canpinaremre/kusbegi-teknofest/DOCUMENT/PAPERS/ecal2.JPG

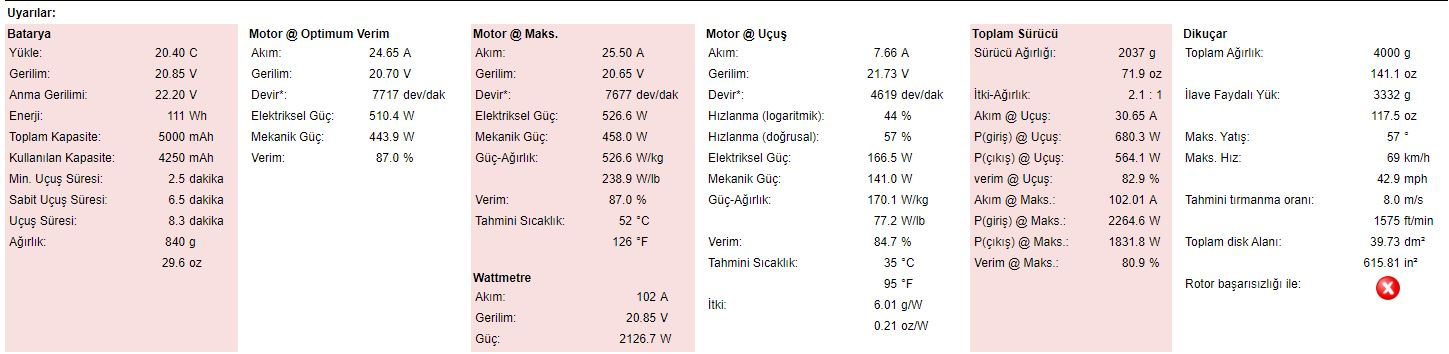
DOCUMENT/PAPERS/ecal2.JPG
