canpinaremre/kusbegi-teknofest/DOCUMENT/PAPERS/ecal1.JPG

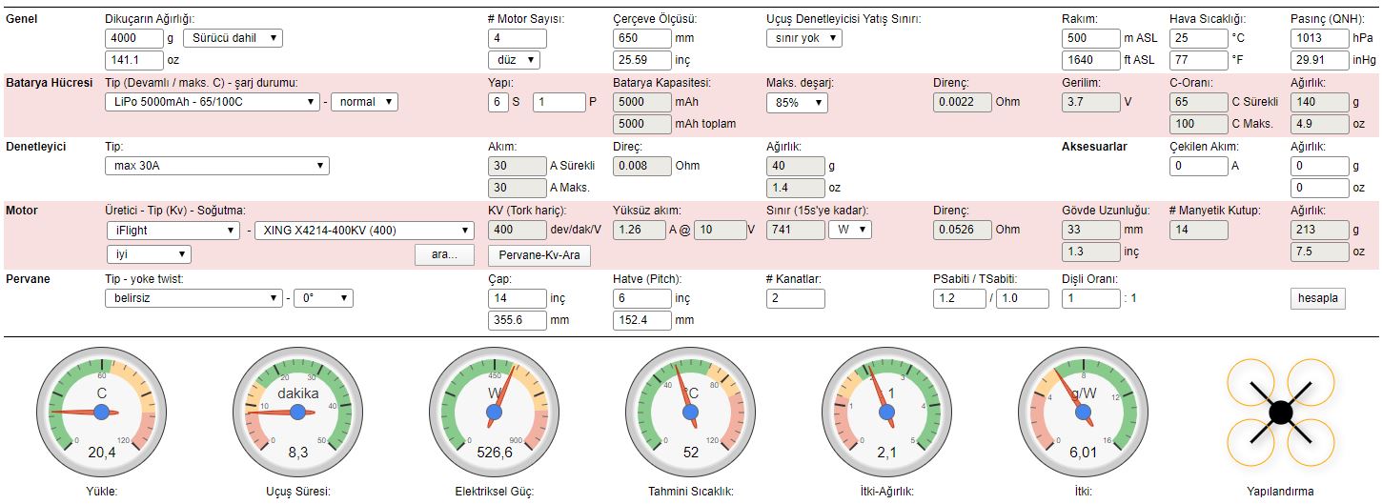
DOCUMENT/PAPERS/ecal1.JPG
