canpinaremre/kusbegi-teknofest/README.md

# kusbegi-teknofest

Araştırma kaynakları ve datasheetler RESEARCH klasörüne konulacak.

Oluşturulan belgeler ve datasetler DOCUMENT klasörüne konulacak.

Yazılımsal tüm içerikler CODE klasörüne konulacak.
