canpinaremre/kusbegi-teknofest/DOCUMENT/PAPERS/Motorlar.docx

SunnySky v3508

https://www.buddyrc.com/sunnysky-v3508-29-380kv.html

https://sunnyskyusa.com/products/sunnysky-v3508-motor

SunnySky v4014

https://sunnyskyusa.com/products/sunnysky-v4014-motors

SunnySky x3525

https://sunnyskyusa.com/products/sunnysky-x3525-brushless-motors-520kv-880kv

SunnySky 4108

https://www.roboshop.com.tr/x4108s-380kv-brushless-fircasiz-drone-motor
