canpinaremre/kusbegi-teknofest/DOCUMENT/PAPERS/COM(Center of Mass) Calculation of Drone.xlsx

Kullanılacak Parça | Ağırlığı(kg) | Ağırlık merkezi koordinatı(x ekseni(en)) | Ağırlık merkezi koordinatı(y ekseni(boy)) | Ağırlık merkezi koordinatı(z ekseni(yükseklik))
Jetson Nano | 0.145 | 67.910 | 0.000 | 73.500
Sigorta | 0.128 | -15.000 | 0.000 | 29.500
Pixhawk 4 | 0.060 | -10.270 | 0.000 | 65.000
GPS + GPS holder | 0.075 | -72.610 | 0.000 | 134.000
Pixhawk Power Module(PM07) | 0.040 | 107.000 | 0.000 | 29.500
Xbee | 0.040 | -30.710 | 91.880 | 64.000
Gövde | 0.393 | 0.000 | 5.000 | 29.500
Motor Tutucu Borular | 0.092 | 0.000 | 0.000 | -11.000
Motorlar(4 adet) | 0.452 | 0.000 | 0.000 | -1.750
Pervaneler(2 adet) | 0.075 | 0.000 | 0.000 | 30.500
Motor Tutucu(4 adet) | 0.088 | 0.000 | 0.000 | -9.500
Vida(67 adet) | 0.134 | 0.000 | 0.000 | -167.000
ESC'ler(4 adet) | 0.092 | 0.000 | 0.000 | 3.000
Pil(6S lipo) | 0.680 | 0.000 | -18.500 | 25.500
Kol sabitleyici(Merkez) | 0.045 | 0.000 | 0.000 | -1.500
Kol sabitleyici(Köşeler - 4 Adet) | 0.060 | 0.000 | 0.000 | -10.000
Receiver | 0.016 | -41.530 | -67.890 | 66.000
UBEC | 0.011 | 0.000 | 102.000 | 29.500
Kablolar | 0.100 | -55.000 | -8.000 | 59.000
Su sensörü ve Motor Sürücü | 0.031 | -74.480 | -84.550 | 63.000
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
