canpinaremre/kusbegi-teknofest/DOCUMENT/PAPERS/Drone Malzemelerinin Boyut ve Ağırlıkları.xlsx

İsim | Boy(cm) | En(cm) | Yükseklik (cm) | Ağırlık(gr)
Pi camera v2 | 25 | 23.86 |  | 3
Jetson Nano | 10 | 8 | 2.9 | 250
Pil (6s) (Profuse 22,2V 7000 mAh) | 15 | 7 | 4.3 | 906
Motor (SunnySky V5210) |  |  |  | 1200
ESC(Sunnysky BLHeli R45A) | 3.9 | 1.8 | 0.4 | 19.3
Pixhawk 4 | 4.4 | 8.4 | 1.2 | 15.8
GPS (Çap = 5 cm) |  |  |  | 36
Pixhawk Power Module | 17 | 5 | 3 | 0.105
Su Pompası (QR30E) | 5.4 | 3.7 | 4.2 | 64
Su(1 lt) |  |  |  | 1000
Sigorta | ? | ? | ? | ?
BEC (Matek PDB-XT60) | 3.6 | 5 | 0.4 | 11
