canpinaremre/kusbegi-teknofest/DOCUMENT/PAPERS/Drone Motor.xlsx

Motor Adı | Max. Akım(A) | KV Değeri | Ağırlık(g) | Max. Thrust(g) | Verim | Prop(inch) | Fiyat(TL) | Volt (V) | Link:
Emax ECO Series 2207 | 32.2 | 1900 | 31 | 1880 | ? | 5 | 264,44 (4PCS) | ? | https://www.banggood.com/4PCS-Emax-ECO-Series-2306-6S-1700KV-Brushless-Motor-for-RC-Drone-FPV-Racing-p-1582958.html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
Racerstar AirA 2508 | 34.7 | 1200 | 46 | 2026 | 2.53 | 7 | 121.77 | 18 | https://www.banggood.com/Racerstar-AirA-2508-1200KV-4-6S-Brushless-Motor-for-Long-Range-X-Class-RC-Drone-FPV-Racing-MultiRotors-p-1454072.html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
Airbot VITE 2306.5 | 34.5 | 1800 | 33.55 | 2772 | 2.115 | 6 | 116.78 | 21 | https://www.banggood.com/Airbot-VITE-2306_5-1800KV-5-6S-2500KV-3-5S-Brushless-Motor-CW-Thread-for-RC-Drone-FPV-Racing-p-1593369.html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
SunnySky X4110S | 18.8 | 400 | 165 | 2430 | 5.82 | 15 | 516.51 | 22.2 | https://www.dronmarket.com/urun/sunnysky-x4110s-drone-motoru
 | 26.6 | 400 | 165 | 2930 | 4.96 | 16 | 516.51 | 22.2
 | 27.7 | 400 | 165 | 3130 | 5.09 | 17 | 516.51 | 22.2
 | 32.2 | 400 | 165 | 3300 | 5.2 | 18 | 516.51 | 22.2
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
