canpinaremre/kusbegi-teknofest/DOCUMENT/PAPERS/DRONE.xlsx

VOLTAGE | PROPELLER | Current | Thrust(g) | Speed(rpm)
24 | DJI 1550 | 9 | 1470 | 5530
24 | DJI 1550 | 10 | 1570 | 5760
24 | DJI 1550 | 11 | 1710 | 5900
24 | DJI 1550 | 12 | 1760 | 6130
24 | DJI 1550 | 13 | 1880 | 6240
24 | DJI 1550 | 14.3 | 2020 | 6450
24 | DJI1655 | 9 | 1530 | 5040
24 | DJI1655 | 10 | 1640 | 5230
24 | DJI1655 | 11 | 1750 | 5390
24 | DJI1655 | 12 | 1830 | 5520
24 | DJI1655 | 13 | 1950 | 5670
24 | DJI1655 | 14 | 2050 | 5790
24 | DJI1555 | 9 | 1500 | 5190
24 | DJI1555 | 10 | 1620 | 5400
24 | DJI1555 | 11 | 1730 | 5530
24 | DJI1555 | 12 | 1820 | 5720
24 | DJI1555 | 13 | 1910 | 5890
24 | DJI1555 | 14 | 2020 | 6000
VOLTAGE | PROPELLER | CURRENT | THRUST | KV
24 | 1660 | 6 | 1311 | 400
24 | 1660 | 10 | 1959 | 400
24 | 1660 | 14.5 | 2564 | 400
24 | 1660 | 20.6 | 3260 | 400
24 | 1560 | 8.6 | 1659 | 400
24 | 1560 | 10.2 | 1904 | 400
24 | 1560 | 17.1 | 2765 | 400
24 | 1560 | 22.3 | 3330 | 400
24 | 1460 | 6.3 | 1267 | 400
24 | 1460 | 9.3 | 1705 | 400
24 | 1460 | 12.9 | 2146 | 400
24 | 1460 | 17.4 | 2683 | 400
VOLTAGE | PROPELLER | AMPS | Thrust | KV
22.2 | 1250 | 9.8 | 1400 | 350
25 | 1250 | 8.5 | 1395 | 350
25 | 1238 | 9.3 | 1400 | 350
25 | 1238 | 10.9 | 1600 | 350
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
