canpinaremre/kusbegi-teknofest/DOCUMENT/PAPERS/İş zaman çizelgesi.xlsx

GÖREVLER | 2020-02-24 | 2020-03-02 | 2020-03-09 | 2020-03-16 | 2020-03-23 | 2020-03-30 | 2020-04-06 | 2020-04-13 | 2020-04-20 | 2020-04-27 | 2020-05-04 | 2020-05-11 | 2020-05-18 | 2020-05-25 | 2020-06-01 | 2020-06-08 | 2020-06-15 | 2020-06-22 | 2020-06-29 | 2020-07-06 | 2020-07-13 | 2020-07-20 | 2020-07-27 | 2020-08-03 | 2020-08-10 | 2020-08-17 | 2020-08-24
Takım içi görevlendirilmelerinin verilmesi ve organizasyonun oluşturulması | X
Genel tasarımın belirlenmesi |  | X
Konfigürasyonun belirlenmesi ve güç parçalarının seçilmesi |  |  | X
İlk tasarımın oluşturulması |  |  | X
Üretim araçlarının araştırılması |  |  |  | X
İlk prototipin oluşturulması ve üretimi
Hataların belirlenmesi ve hataları düzelterek modelin geliştirilmesi
Kullanılacak yazılımın simülasyonu |  |  |  | X
İlk uçuş testlerinin yapılması
Otonom uçuş testlerinin gerçekleştirilmesi
Yarışma düzenin kurulması ve yarışma testlerinin gerçekleştirilmesi
Gerekli yazılımsal ayarlamaların tamamlanması ve son ürüne ulaşma
