canpinaremre/kusbegi-teknofest/DOCUMENT/SOLIDWORKS/DRONE V1 GÖRÜNTÜ 1.PNG

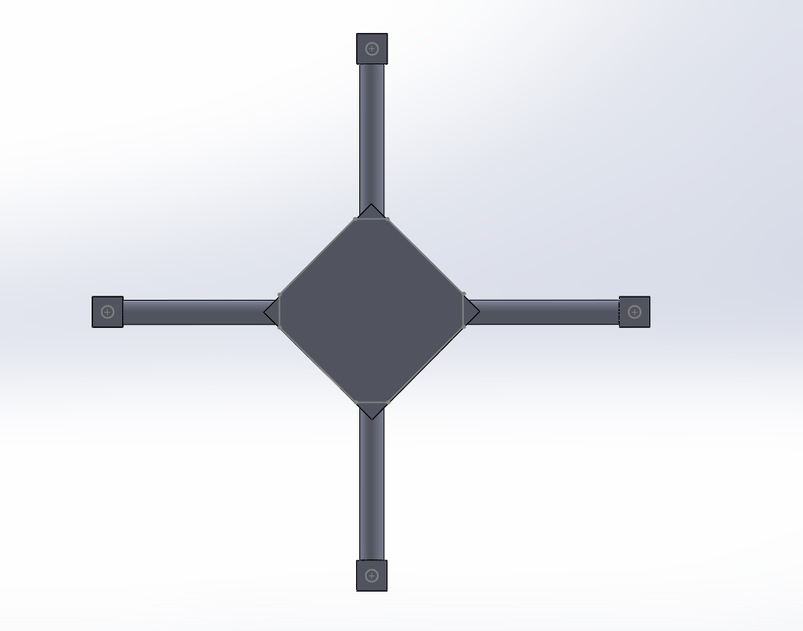
DOCUMENT/SOLIDWORKS/DRONE V1 GÖRÜNTÜ 1.PNG
