canpinaremre/kusbegi-teknofest/DOCUMENT/SOLIDWORKS/DRONE V1 GÖRÜNTÜ 2.PNG

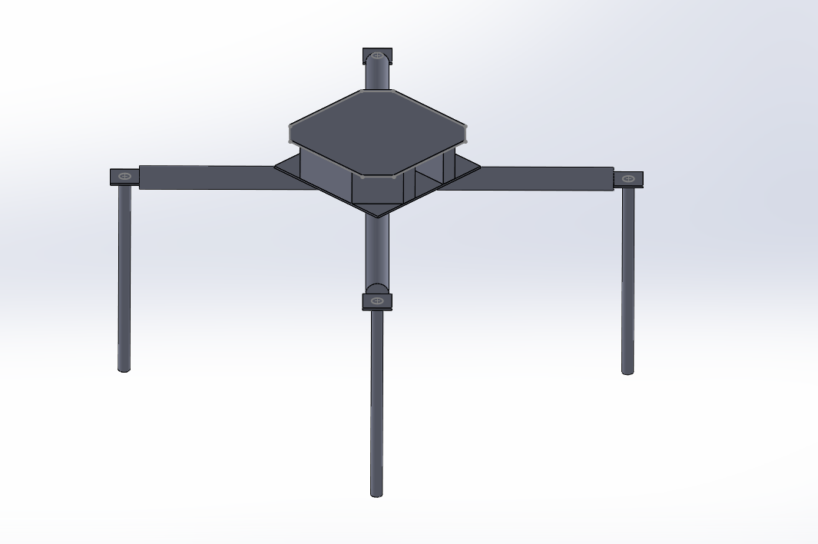
DOCUMENT/SOLIDWORKS/DRONE V1 GÖRÜNTÜ 2.PNG
