canpinaremre/kusbegi-teknofest/DOCUMENT/SOLIDWORKS/DRONE V1 GÖRÜNTÜ 3.PNG

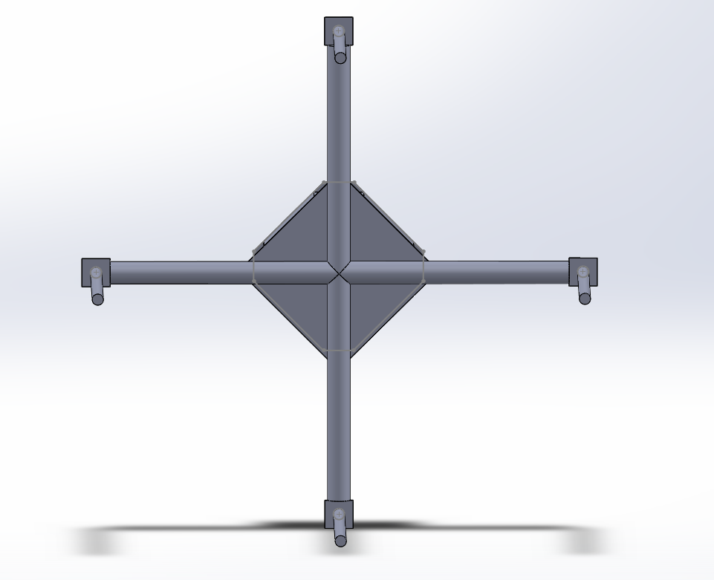
DOCUMENT/SOLIDWORKS/DRONE V1 GÖRÜNTÜ 3.PNG
