canpinaremre/kusbegi-teknofest/DOCUMENT/SOLIDWORKS/DRONE V1 GÖRÜNTÜ 4.PNG

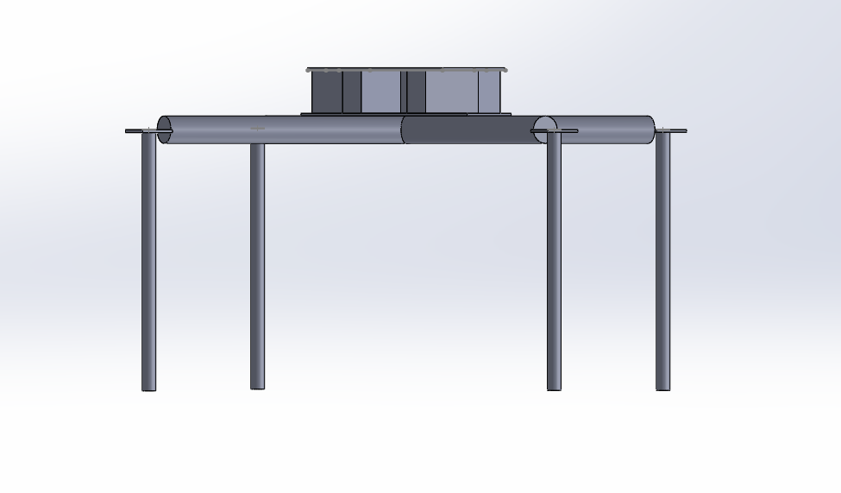
DOCUMENT/SOLIDWORKS/DRONE V1 GÖRÜNTÜ 4.PNG
