canpinaremre/kusbegi-teknofest/DOCUMENT/SOLIDWORKS/DRONE V1 GÖRÜNTÜ 5.PNG

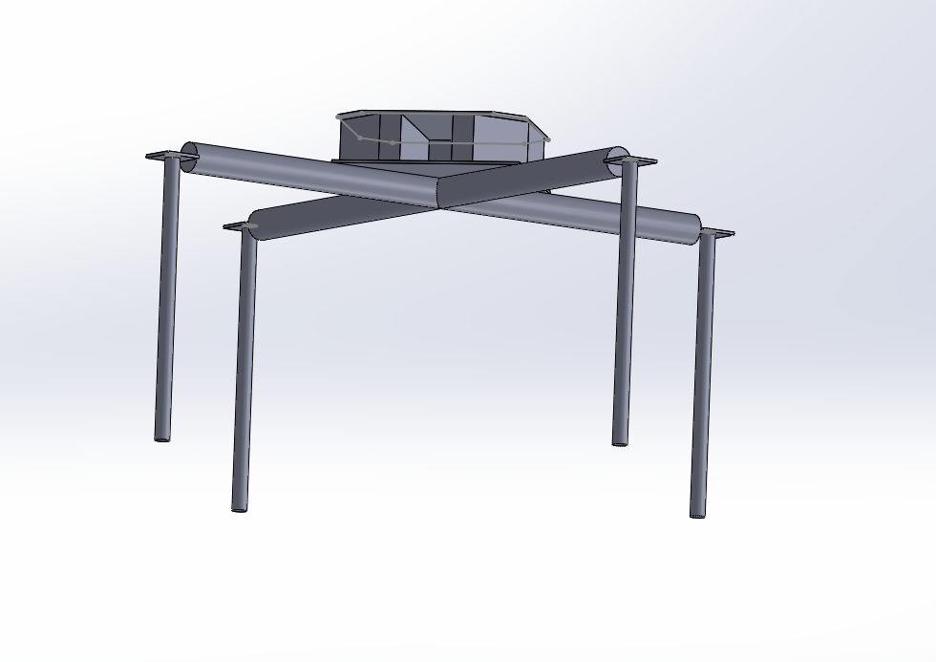
DOCUMENT/SOLIDWORKS/DRONE V1 GÖRÜNTÜ 5.PNG
