canpinaremre/kusbegi-teknofest/DOCUMENT/SOLIDWORKS/DRONE V1 GÖRÜNTÜ 6.PNG

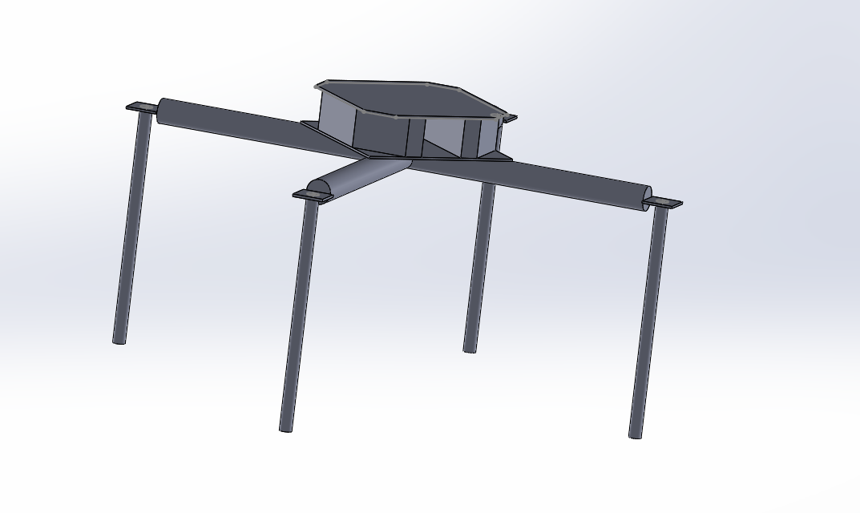
DOCUMENT/SOLIDWORKS/DRONE V1 GÖRÜNTÜ 6.PNG
