canpinaremre/kusbegi-teknofest/DOCUMENT/SOLIDWORKS/DRONE V1 GÖRÜNTÜ 7.PNG

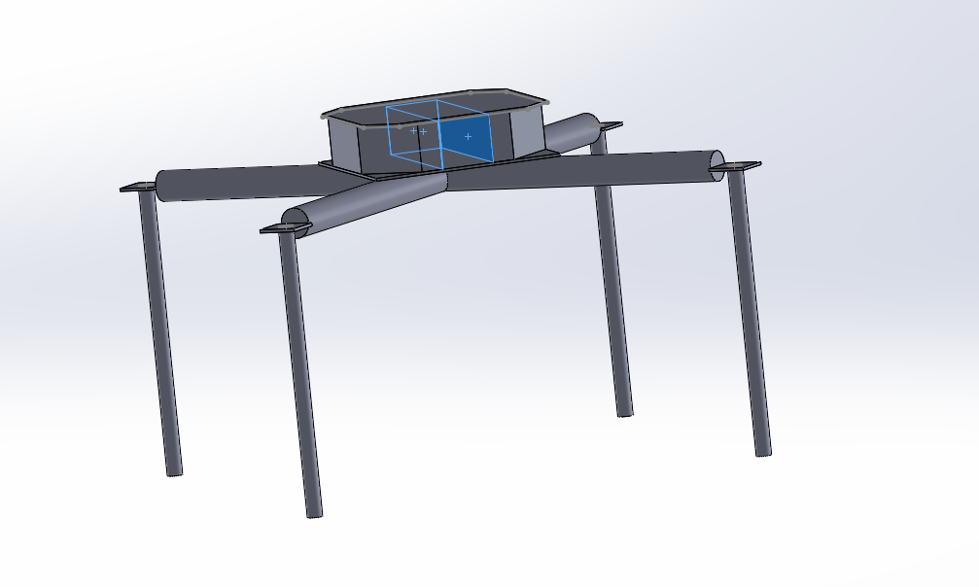
DOCUMENT/SOLIDWORKS/DRONE V1 GÖRÜNTÜ 7.PNG
