canpinaremre/kusbegi-teknofest/DOCUMENT/SOLIDWORKS/DRONE V1 GÖRÜNTÜ 8.PNG

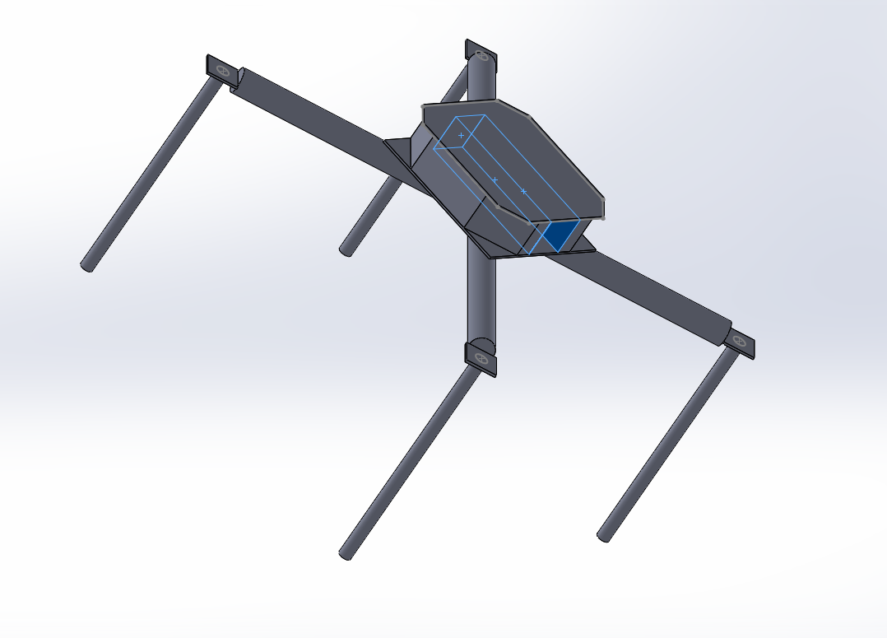
DOCUMENT/SOLIDWORKS/DRONE V1 GÖRÜNTÜ 8.PNG
