canpinaremre/kusbegi-teknofest/(list of files, cad)

Other CAD files:
DOCUMENT/SOLIDWORKS/kusbegi.dwg
