canpinaremre/kusbegi-teknofest/CODE/circuit diagram v4.pdf

# Li-po Batarya 6s

# Sigorta

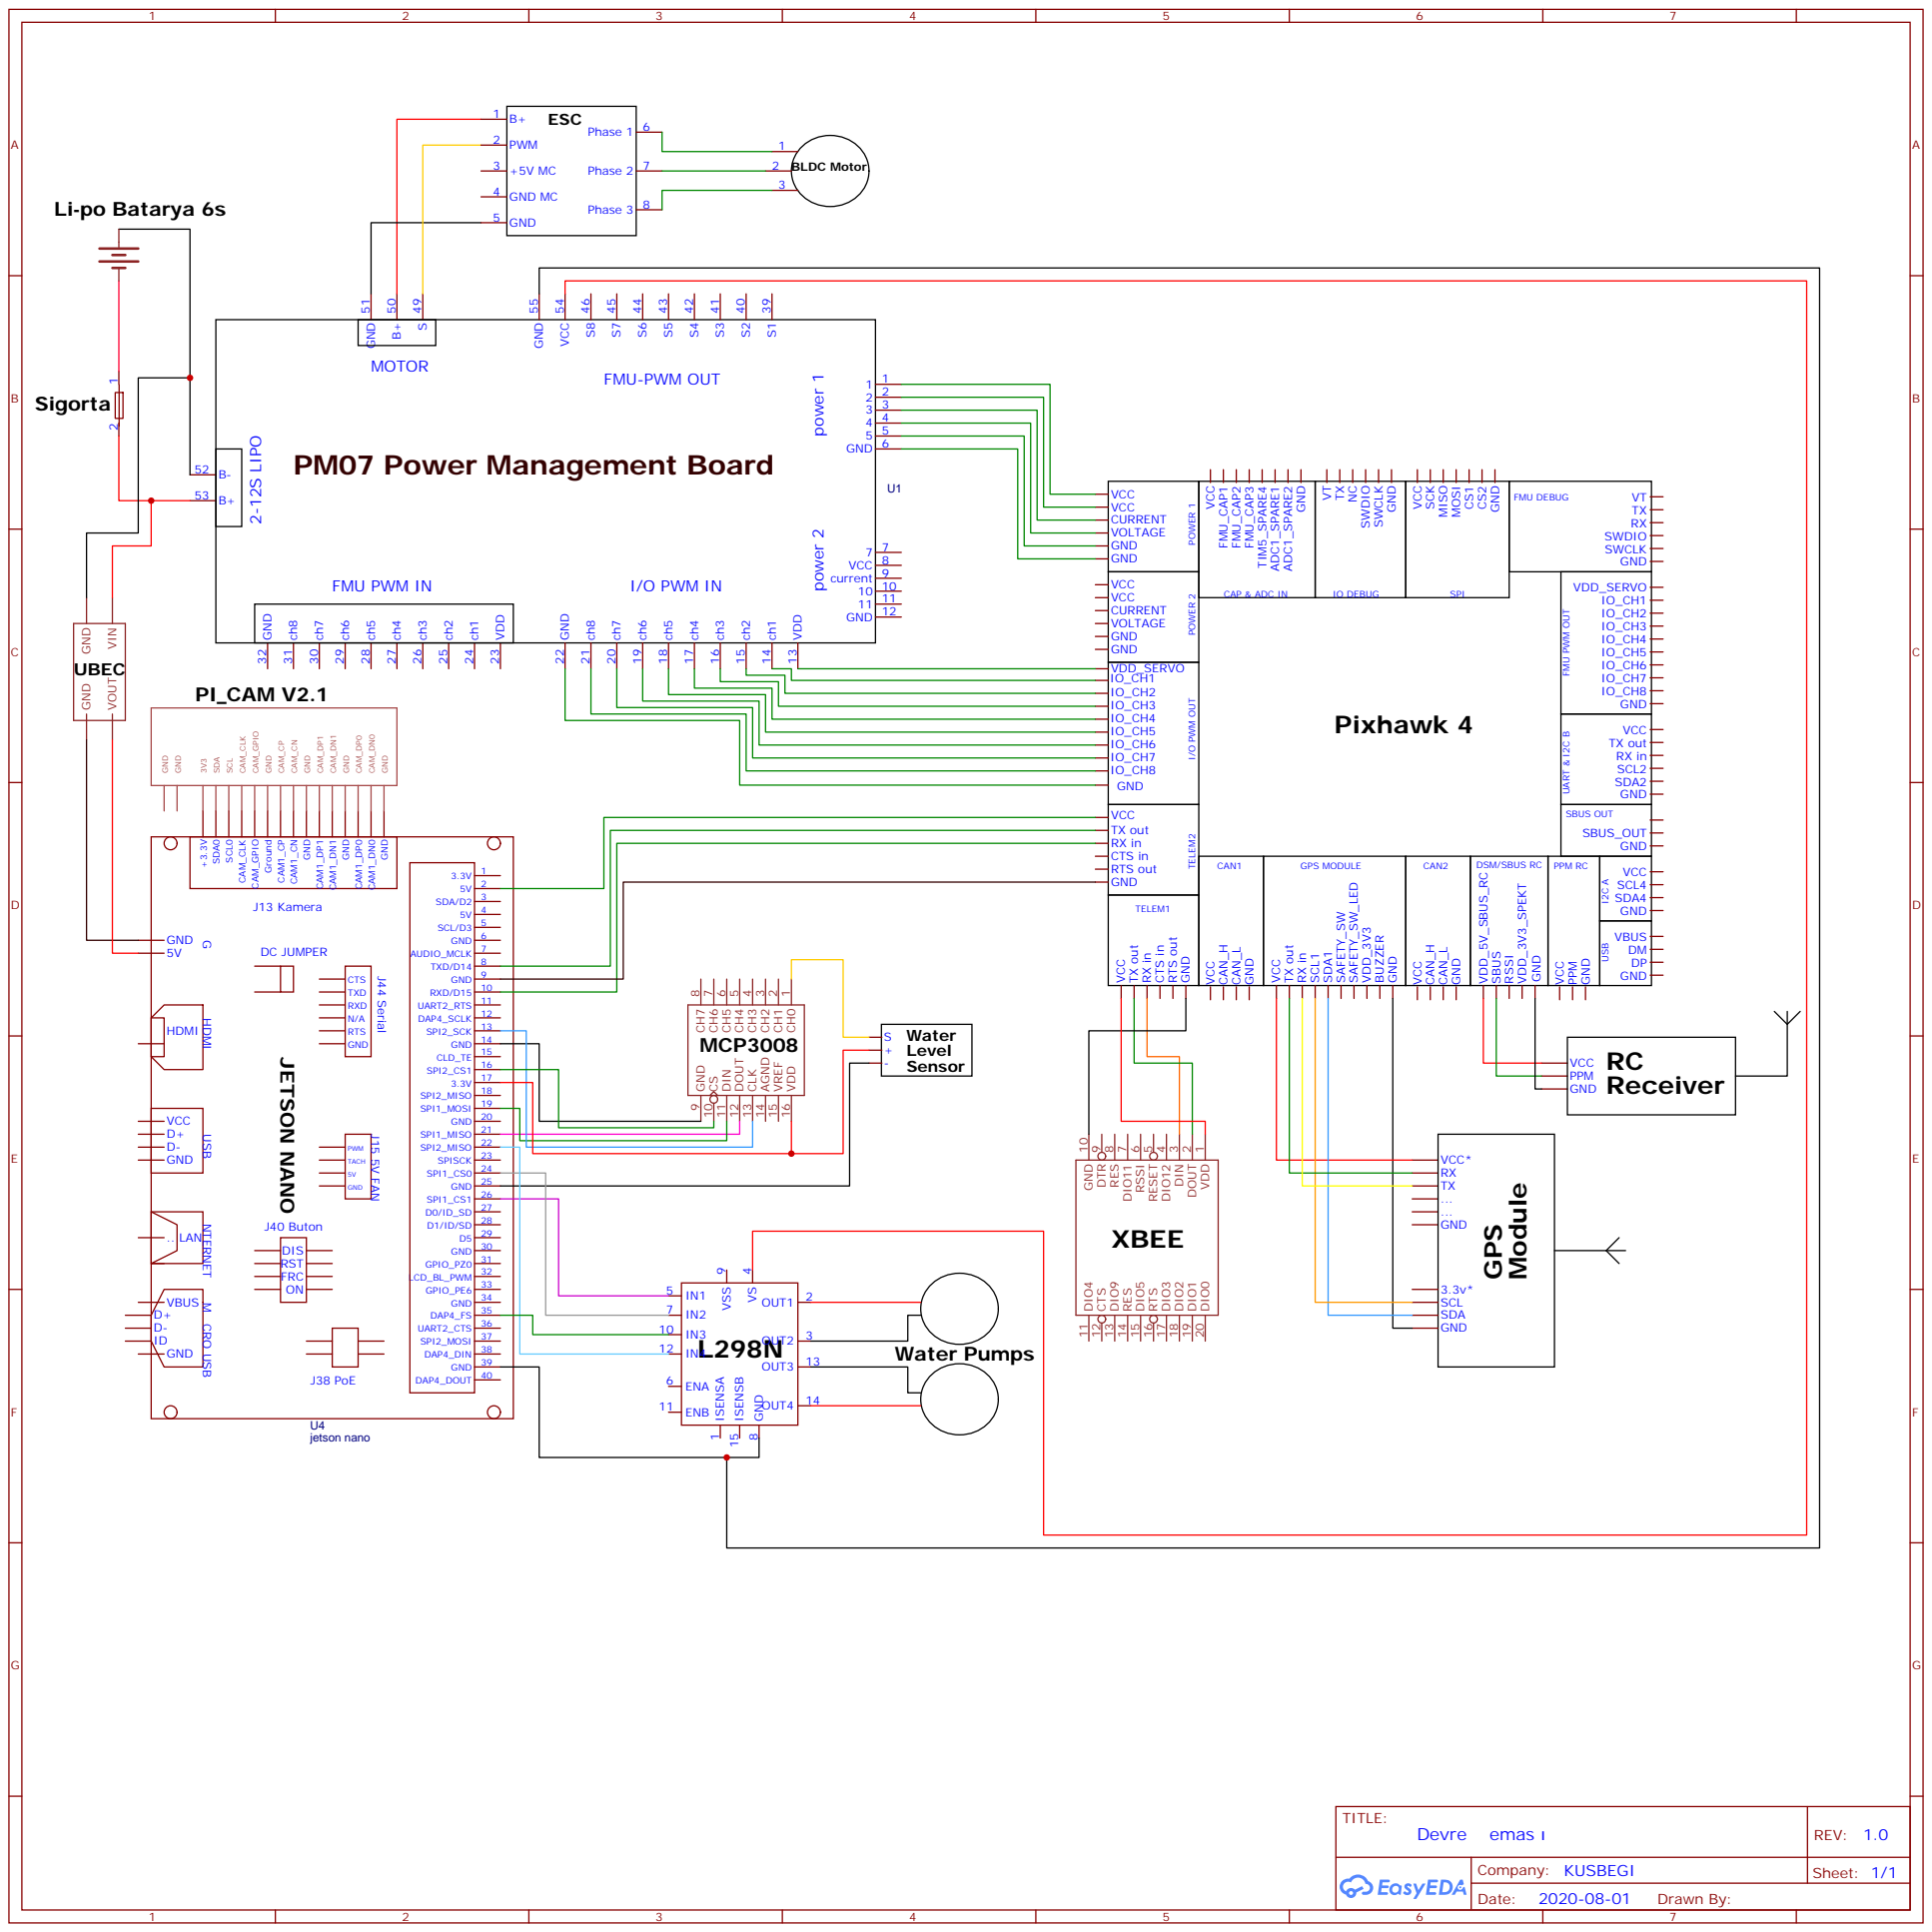
[picture p34: page 1]

SBUS OUT
SBUS_OUT
GND
PPM RC VCC PPM GND

MCP3008 CS 10 DIN 11 DOUT 12 CLK 13 AGND 14 VREF 15 VDD 16 GND
