canpinaremre/kusbegi-teknofest/RESEARCH/Schematic_circuitdiag_2020-07-17_20-28-37.pdf

A

A

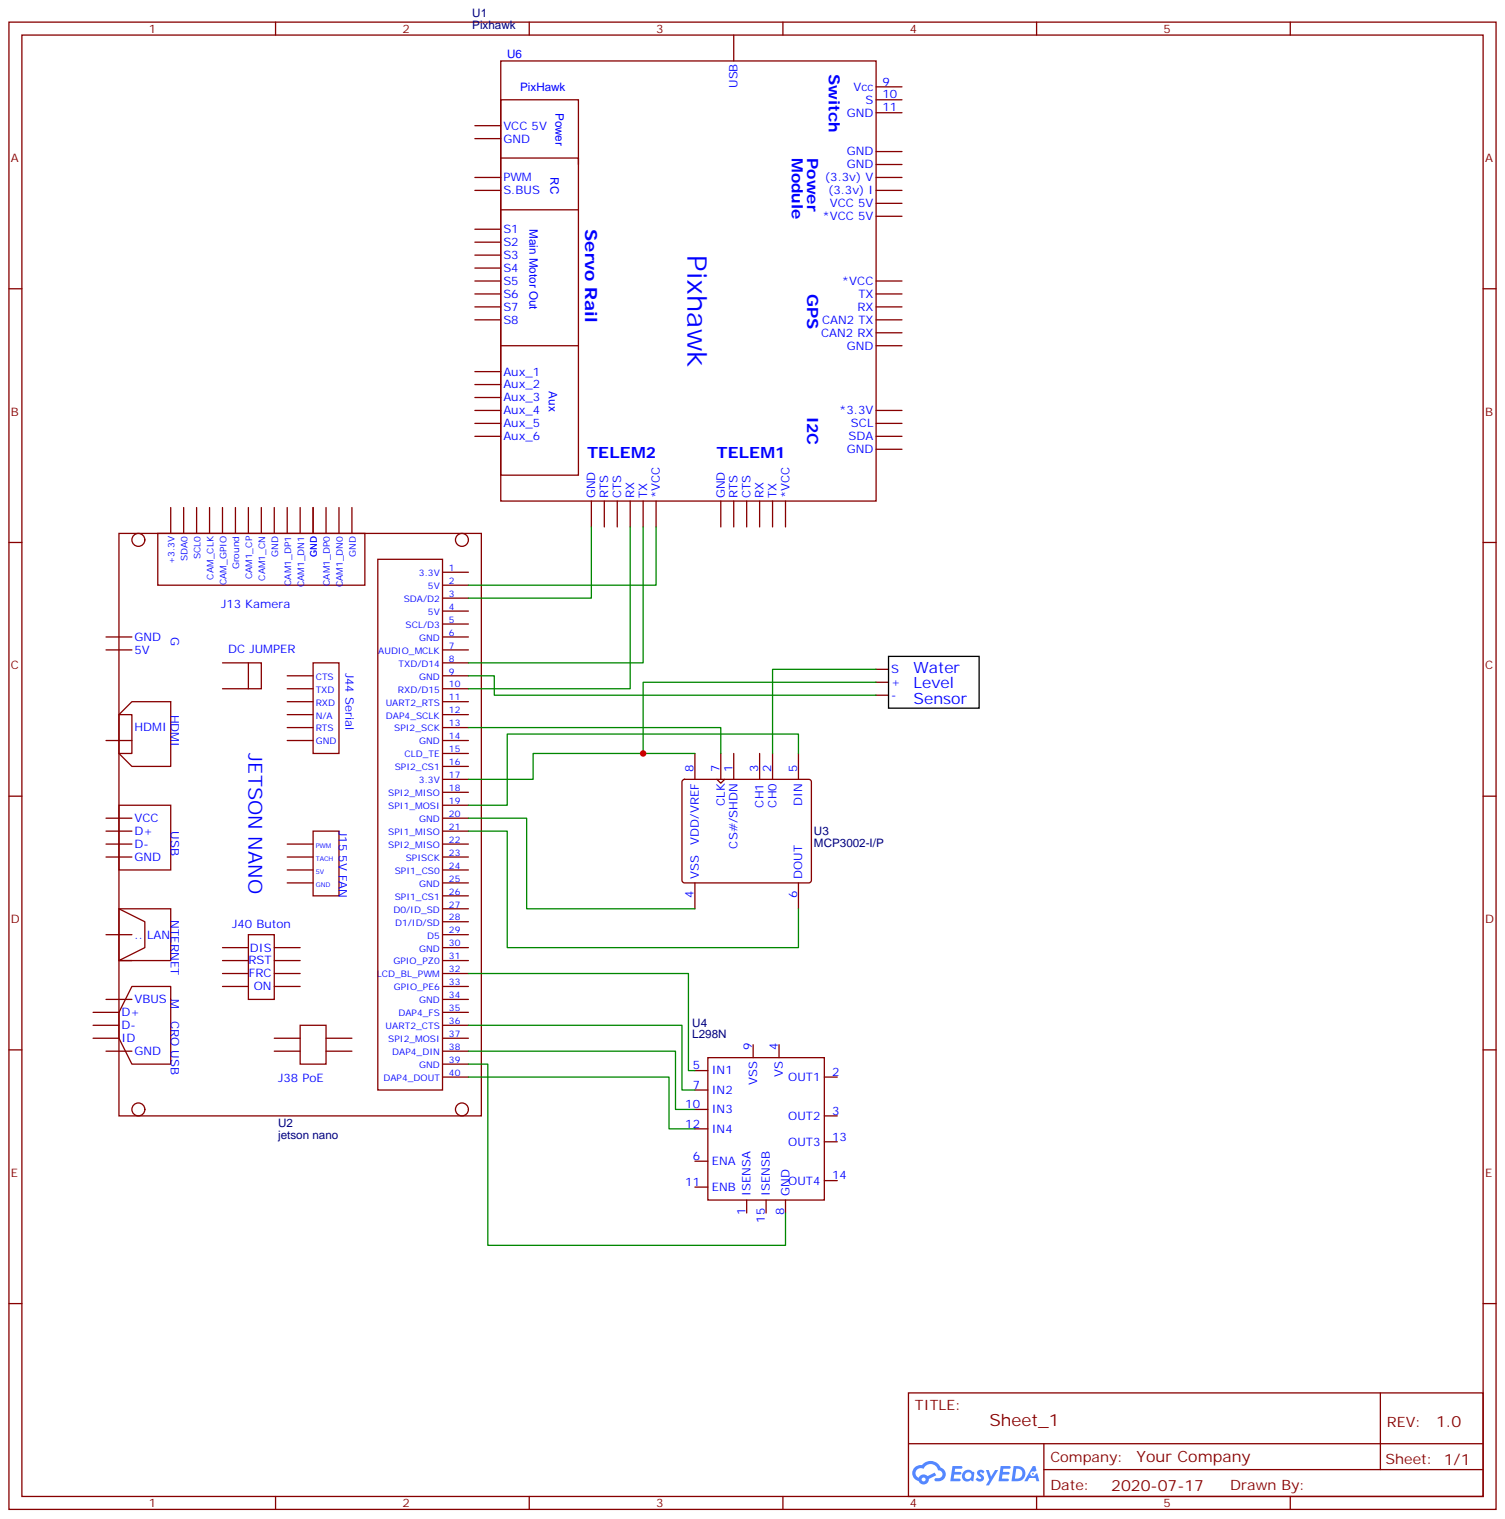
[picture p35: page 1]

G HDMI USB NTERNET M CRO USB
