canpinaremre/kusbegi-teknofest/CODE/water_sensor_v4.py

import RPi.GPIO as GPIO
import time

# change these as desired - they're the pins connected from the
# SPI port on the ADC to the Cobbler
SPICLK = 13
SPIMISO = 21
SPIMOSI = 19
SPICS = 16

# photoresistor connected to adc #0
photo_ch = 0


# port init
def init():
    GPIO.setwarnings(False)
    GPIO.cleanup()  # clean up at the end of your script
    GPIO.setmode(GPIO.BOARD)  # to specify whilch pin numbering system
    # set up the SPI interface pins
    GPIO.setup(SPIMOSI, GPIO.OUT)
    GPIO.setup(SPIMISO, GPIO.IN)
    GPIO.setup(SPICLK, GPIO.OUT)
    GPIO.setup(SPICS, GPIO.OUT)


# read SPI data from MCP3008(or MCP3204) chip,8 possible adc's (0 thru 7)
def readadc(adcnum, clockpin, mosipin, misopin, cspin):
    if ((adcnum > 7) or (adcnum < 0)):
        return -1
    GPIO.output(cspin, True)

    GPIO.output(clockpin, False)  # start clock low
    GPIO.output(cspin, False)  # bring CS low

    commandout = adcnum
    commandout |= 0x18  # start bit + single-ended bit
    commandout <<= 3  # we only need to send 5 bits here
    for i in range(5):
        if (commandout & 0x80):
            GPIO.output(mosipin, True)
        else:
            GPIO.output(mosipin, False)
        commandout <<= 1
        GPIO.output(clockpin, True)
        GPIO.output(clockpin, False)

    adcout = 0
    # read in one empty bit, one null bit and 10 ADC bits
    for i in range(12):
        GPIO.output(clockpin, True)
        GPIO.output(clockpin, False)
        adcout <<= 1
        if (GPIO.input(misopin)):
            adcout |= 0x1

    GPIO.output(cspin, True)

    adcout >>= 1  # first bit is 'null' so drop it
    return adcout


def main():
    init()
    time.sleep(2)
    print
    "will start detec water level\n"
    while True:
        adc_value = readadc(photo_ch, SPICLK, SPIMOSI, SPIMISO, SPICS)
        print
        "water level:" + str("%.1f" % (adc_value / 200. * 100)) + "%\n"
        print
        "adc_value= " +str(adc_value)+"\n"
        time.sleep(1)


if __name__ == '__main__':
    try:
        main()

    except KeyboardInterrupt:
        pass
GPIO.cleanup()
