canpinaremre/kusbegi-teknofest/2021/mcu.py

from dronekit import connect, LocationLocal, LocationGlobalRelative
from pymavlink import mavutil
from time import sleep
import threading


import math
import cv2
import numpy as np

#connection_string = "/dev/ttyTHS1"
connection_string = '127.0.0.1:14540'
#vehicle = connect(connection_string, baud=57600)

def send(red_x,red_y,red_size):
	vehicle._master.mav.command_long_send(
                1,  	  # autopilot system id
                1,  	  # autopilot component id
                35, 	  # command id, 35 = VEHICLE_CMD_DO_KUSBEGI
                0,  	  # confirmation
                red_x,    # param1
                red_y,	  # param2
		red_size, # param3
		0,	  # param4
		0,	  # param5
		0,	  # param6
		0  	  # param7
        )

red_thread = threading.Thread(target=send_message)
mission_thread = threading.Thread(target=get_message)
red_thread.start()
mission_thread.start()





#color settings
hue_lower = 160
hue_upper = 180
saturation_lower = 100
saturation_upper = 255
value_lower = 20
value_upper = 255

hue_lower2 = 0
hue_upper2 = 10
saturation_lower2 = 100
saturation_upper2 = 255
value_lower2 = 20
value_upper2 = 255

min_contour_area = 200

horizontal_resolution = 1280
vertical_resolution = 720

camera = cv2.VideoCapture(0)

def send_message():

	while(1):
        size = 0
        _,capture = camera.read()
    	hsvcapture = cv2.cvtColor(capture,cv2.COLOR_BGR2HSV)
    	inrangepixels1 = cv2.inRange(hsvcapture,np.array((hue_lower,saturation_lower,value_lower)),np.array((hue_upper,saturation_upper,value_upper)))#in opencv, HSV is 0-180,0-255,0-255
    	inrangepixels2 = cv2.inRange(hsvcapture,np.array((hue_lower2,saturation_lower2,value_lower2)),np.array((hue_upper2,saturation_upper2,value_upper2)))#in opencv, HSV is 0-180,0-255,0-255
    	inrangepixels = inrangepixels1 + inrangepixels2
    	tobecontourdetected = inrangepixels.copy()
    	#TODO filter better. binary morphology would be a good start.
    	contours,hierarchy = cv2.findContours(tobecontourdetected,cv2.RETR_LIST,cv2.CHAIN_APPROX_SIMPLE)

    	contour_sizes=[]
    	contour_centroids = []
    	for contour in contours:
    		real_area = cv2.contourArea(contour)
    		if real_area > min_contour_area:
    		        M = cv2.moments(contour) #moment is centroid
    		        cx,cy = int(M['m10']/M['m00']), int(M['m01']/M['m00'])
    		        cv2.circle(capture,(cx,cy),5,(0,0,255),-1)#BGR
    		        contour_sizes.append(real_area)
    		        contour_centroids.append((cx,cy))

    	#find biggest contour (by area)
    	biggest_contour_index = 0
    	for i in range(1,len(contour_sizes)):
    		if contour_sizes[i] > contour_sizes[biggest_contour_index]:
    		        biggest_contour_index = i
			size = contour_sizes[i]
    	biggest_contour_centroid=None
    	if len(contour_sizes)>0:
    		biggest_contour_centroid=contour_centroids[biggest_contour_index]

    	#if the biggest contour was found, color it blue and send the message
    	if biggest_contour_centroid is not None:
    		cv2.circle(capture,biggest_contour_centroid,5,(255,0,0),-1)
    		x,y = biggest_contour_centroid
            body_right = (x - horizontal_resolution/2)
        	body_forward = (vertical_resolution/2 - y)
            #TODO:
    		#send(body_forward,body_right,size)
            print("x: ",x)
            print("y: ",y)
            print("size: ",size)
            print("forward: ",body_forward)
            print("right: ",body_right)
        #TODO delete sleep and print
        sleep(0.5)
        cv2.imshow('capture',capture)
        cv2.imshow('inrangepixels',inrangepixels)


def get_message():
	while(1):
		state = vehicle.parameters['NAV_FW_ALT_RAD']
		param = vehicle.parameters['NAV_FW_ALTL_RAD'] # comfirm

		if((state == 1) and (param == 0)): #take water
			#take water
			print("take water")
			#TODO
		elif((state == 2) and (param == 0)): #dump water
			#dump water
			print("dump water")
			#TODO
        
