canpinaremre/kusbegi-teknofest/CODE/su_sensoru_class_test.py

from utility import WaterLevelSensor
from time import sleep


sens = WaterLevelSensor()



while True:
    sleep(0.2)
    adc_value = sens.readadc(sens.photo_ch, sens.SPICLK, sens.SPIMOSI, sens.SPIMISO, sens.SPICS)
    print(str(adc_value))
