canpinaremre/kusbegi-teknofest/(commit log)

2020-03-03 bu seferde o
    [BASALINS.xlsx]
2020-03-04 İş zaman çizelgesi eklendi
    İş zaman çizelgesi eklendi.henüz veri işlenmedi
    [İş zaman çizelgesi.xlsx]
2020-03-04 test dosyası silindi
    elif test dosyası silindi
    [BASALINS.xlsx]
2020-03-04 Motor araştırması ve kullanılacak parçaların boyut-ağırlık bilgileri eklendi. -B
    [Drone Malzemelerinin Boyut ve Ağırlıkları.xlsx, Drone Motor.xlsx]
2020-03-05 Excell 2. motor Xing4214
    [DRONE.xlsx]
2020-03-09 autocad deneme cizimi
    [kusbegi.dwg]
2020-03-09 Drone gövdesinin ilk prototipi çizildi. -B
    [Teknofest Depo ve Gövde v2.SLDPRT, Teknofest Gövde v1.SLDPRT]
2020-03-09 Kanat kollarının çizimi tamamlandı ancak gövdeyle birleştirilmedi.-B
    [Kanat Kolları v1.SLDPRT]
2020-03-16 DRONE V1 tam hal çizimi, parçaları, görselleri ayrı ayrı yüklendi. -B
    [DRONE V1 (Tam Çizim).SLDASM, Gövde ve Kollar V1.SLDPRT, Kanat Kolları V2 aynalanmış.SLDPRT, Kanat Kolları V2.SLDPRT, Teknofest Depo.SLDPRT, Teknofest Gövde V2.SLDPRT]
2020-03-16 DRONE V1 İsoyla beraber düzenlenip, DRONE V3 olarak ayrıca kaydedildi. -B
    [DRONE V1 (Tam Çizim).SLDASM, DRONE V3 (Tam Çizim).SLDASM, Kanat Kolları V2 aynalanmış.SLDPRT, Teknofest Gövde V2.SLDPRT]
2020-03-17 Kavramsal tasarım raporu güncellendi
    [İş zaman çizelgesi.xlsx]
2020-07-02 Tahmini ağırlık merkezi Excel ile hesaplandı ve yazıldı.
    [COM(Center of Mass) Calculation of Drone.xlsx]
2020-09-04 Add files via upload
    Jetson nano fan_pwm setup, initial setup,, dronekit-mavlink libraries, opencv_4.4(with cuda), reference links etc.
2020-09-04 Add files via upload
    Jetson Nano & Pixhawk-4 UART connection script
2020-09-04 Add files via upload
    CSI_Camera class to call in main script to get frames from CSI Camera with thread.
2020-09-04 Add files via upload
    Basic capture & show script.
    Creates a CSI camera object with using csi_camera.py .
    Also calculates FPS value and writes on shown image.
2020-09-09 utility pump pin mode
2020-09-10 Create Target_Red.py
    to get X and Y errors and to get biggest detected red contour's area
    self.lower_red and self.upper_red values can be edited.
    X and Y errors -> self.errX and self.errY
    to get contour area -> self.con_area
    [Target_Red.py]
2020-09-13 Create g2_test_cam.py
    can not pass thread.stop() and break while situation
2020-09-16 su sensoru
2020-09-17 working pump test
2020-09-17 pump in and out test
2020-09-17 yeni cam class thread deneme
2020-09-17 yeni camera class thread main deneme
2021-08-25 drive with body frame establish
